OLIMEX/iMX8MP-SOM/README.md

# iMX8MP-SOM
i.MX8MPlus System on Module with iMX8 SOC
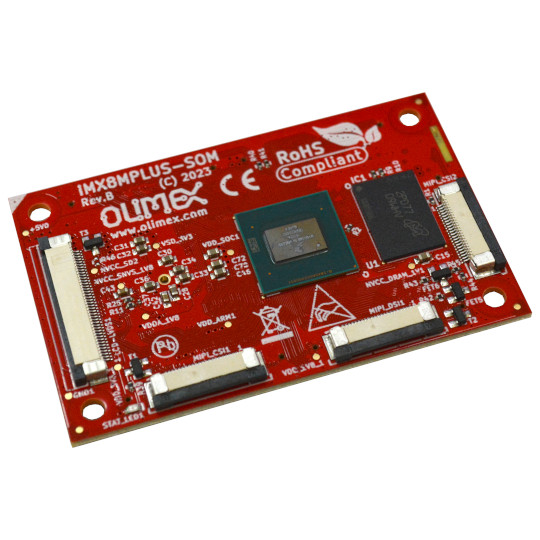
[picture p1: DOCUMENTS/imx8mp-som.jpg]
imx8mp-som


## Licensee
* Hardware is released under CERN Open Hardware Licence Version 2 - Strongly Reciprocal
* Software is released under GPL V3 Licensee
* Documentation is released under CC BY-SA 4.0
