OLIMEX/iMX8MP-SOM/HARDWARE/README.txt

The design was made with KiCAD version 5.1.12.

If you notice problems with PCB or schematic, please use exactly the same version.
