OLIMEX/iMX8MP-SOM/DOCUMENTS/imx8mp-som-a.jpg

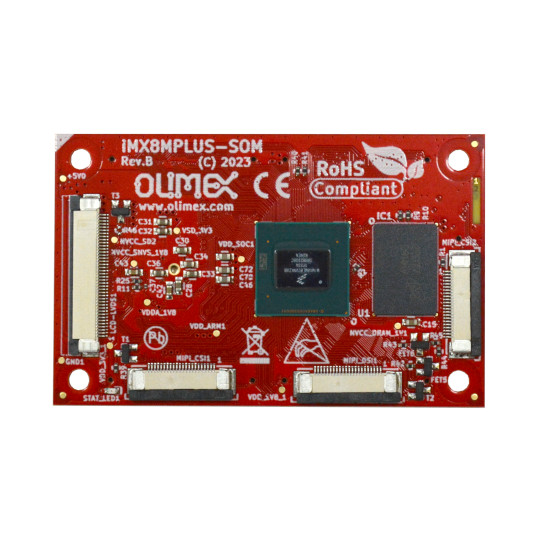
DOCUMENTS/imx8mp-som-a.jpg
