OLIMEX/iMX8MP-SOM/DOCUMENTS/imx8mp-som-b.jpg

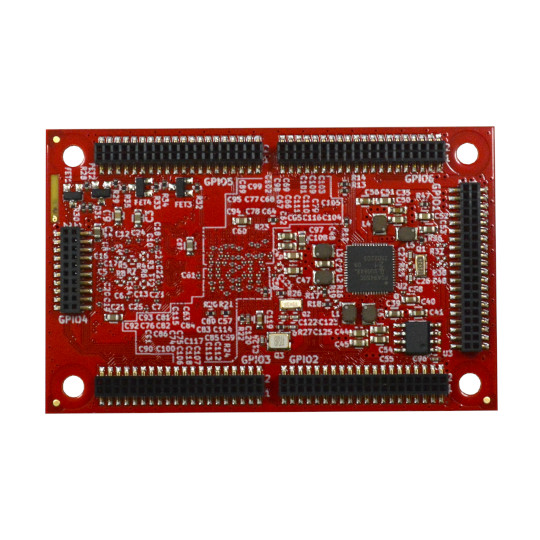
DOCUMENTS/imx8mp-som-b.jpg
