OLIMEX/iMX8MP-SOM/HARDWARE/iMX8MP-SOM-xGB-IND/3d/FPV-WZB21-22-LF_Molex-524372233.stp

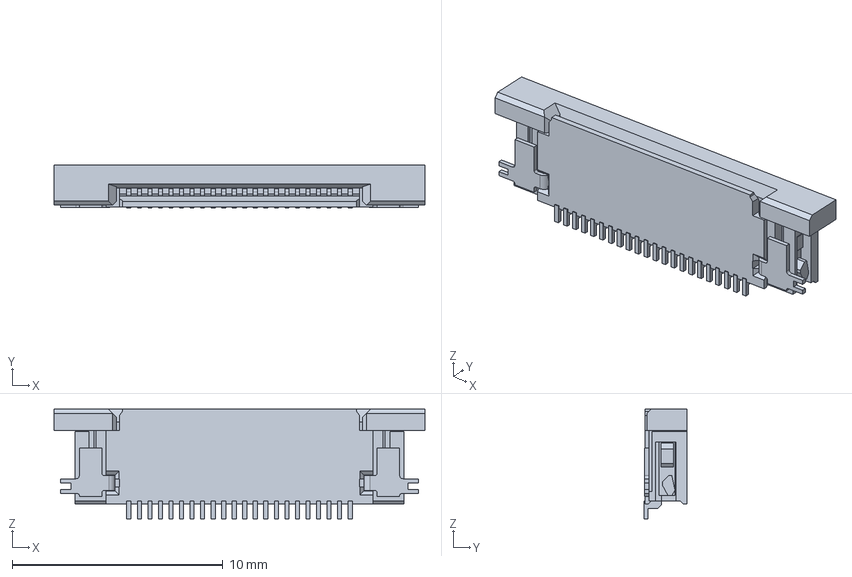
[picture p4: CAD file, 2024-09-25]
HARDWARE/iMX8MP-SOM-xGB-IND/3d/FPV-WZB21-22-LF_Molex-524372233.stp
17.6 x 2.04 x 5.20 mm
