OLIMEX/iMX8MP-SOM/HARDWARE/iMX8MP-SOM-xGB-IND/3d/QSG5032.step

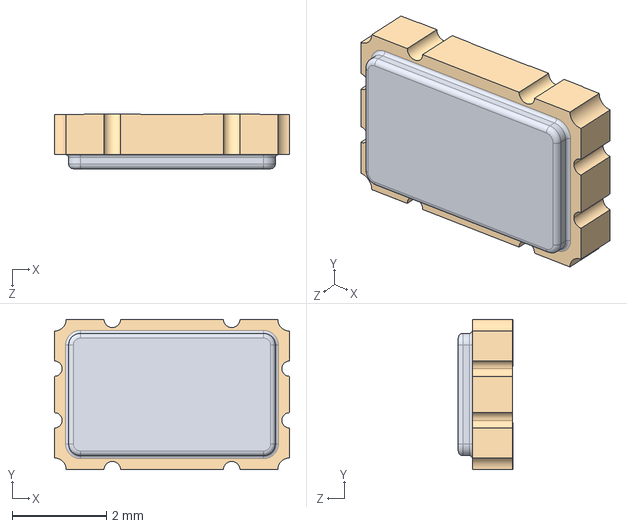
[picture p5: CAD file, 2024-09-25]
HARDWARE/iMX8MP-SOM-xGB-IND/3d/QSG5032.step
5.00 x 3.20 x 1.16 mm
