OLIMEX/iMX8MP-SOM/HARDWARE/iMX8MP-SOM-xGB-IND/3d/L-INDM2520X190N.STEP

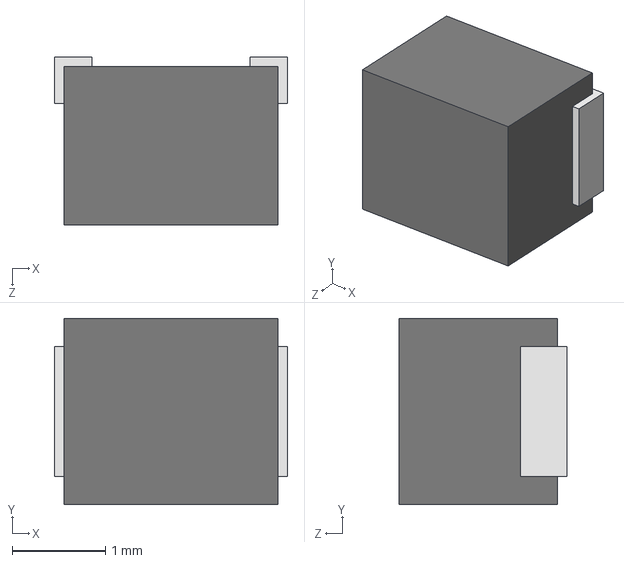
[picture p6: CAD file, 2024-09-25]
HARDWARE/iMX8MP-SOM-xGB-IND/3d/L-INDM2520X190N.STEP
2.50 x 2.00 x 1.80 mm
