OLIMEX/iMX8MP-SOM/HARDWARE/iMX8MP-SOM-xGB-IND/3d/SO-8_150mil---SN65HVDA1050AQDRQ1.STEP

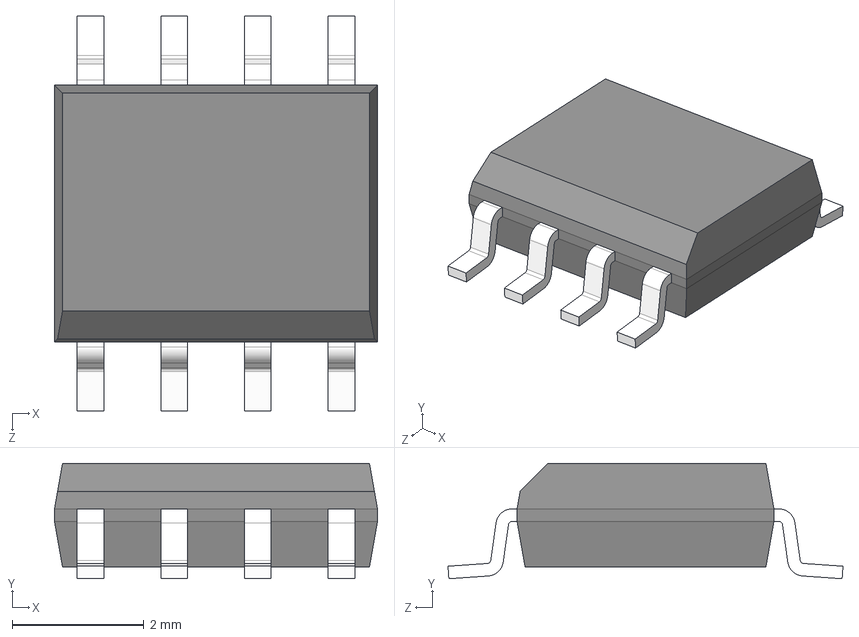
[picture p7: CAD file, 2024-09-25]
HARDWARE/iMX8MP-SOM-xGB-IND/3d/SO-8_150mil---SN65HVDA1050AQDRQ1.STEP
4.90 x 1.75 x 5.99 mm
