OLIMEX/iMX8MP-SOM/HARDWARE/iMX8MP-SOM-xGB-IND/3d/SOT-23.step

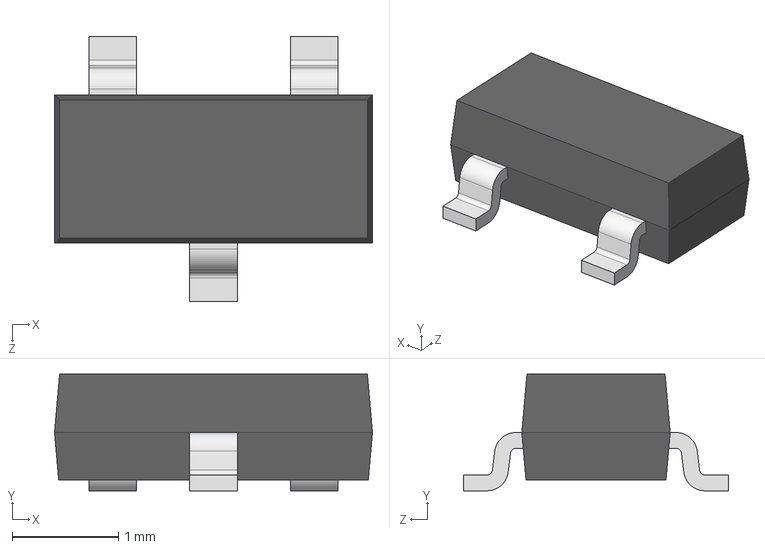
[picture p8: CAD file, 2024-09-25]
HARDWARE/iMX8MP-SOM-xGB-IND/3d/SOT-23.step
3.00 x 1.10 x 2.50 mm
