OLIMEX/iMX8MP-SOM/HARDWARE/iMX8MP-SOM-xGB-IND/3d/User Library-HQFN 56.STEP

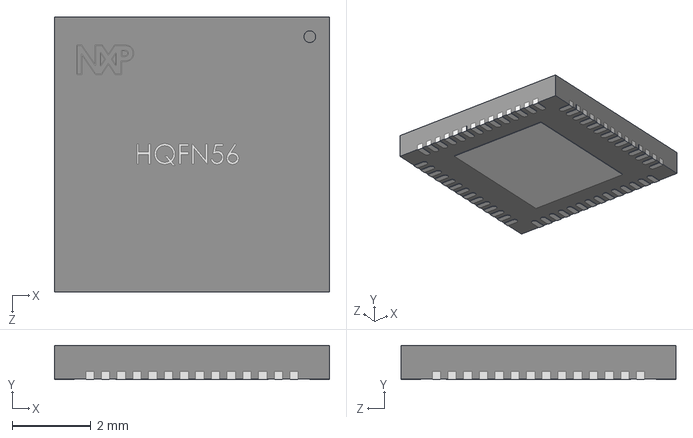
[picture p9: CAD file, 2024-09-25]
HARDWARE/iMX8MP-SOM-xGB-IND/3d/User Library-HQFN 56.STEP
7.00 x 0.87 x 7.00 mm
