OLIMEX/iMX8MP-SOM/HARDWARE/iMX8MP-SOM-xGB-IND/3d/BGA-200(IS46LQ32128A-062BLA).STEP

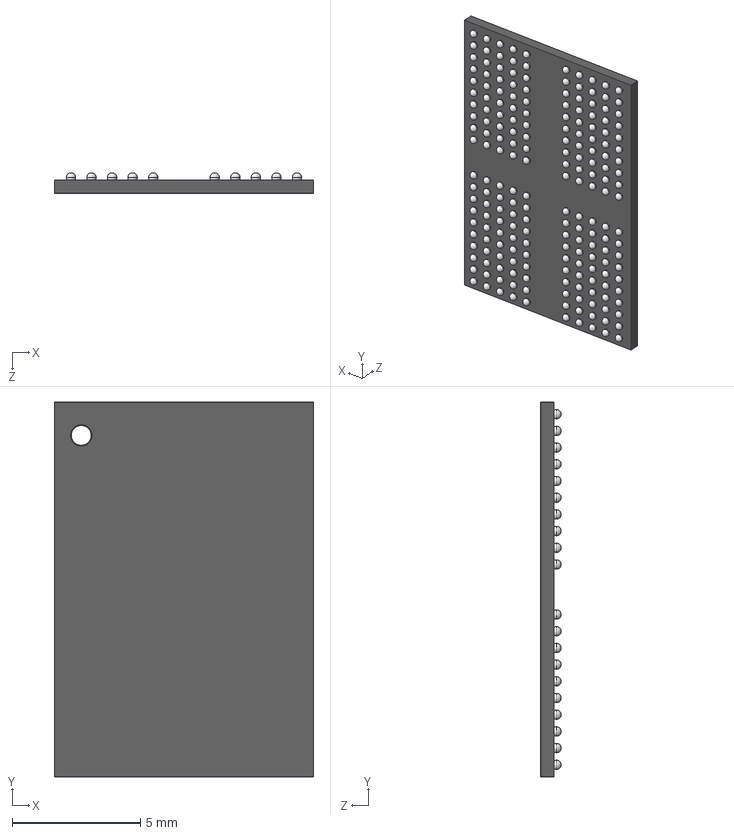
[picture p10: CAD file, 2024-09-25]
HARDWARE/iMX8MP-SOM-xGB-IND/3d/BGA-200(IS46LQ32128A-062BLA).STEP
10.1 x 14.6 x 0.8 mm
