OLIMEX/iMX8MP-SOM/HARDWARE/iMX8MP-SOM-xGB-IND/3d/Q32.768kHz_12.5pF_2P_SMD1206---ECS-.327-12.5-34B-C-TR.STEP

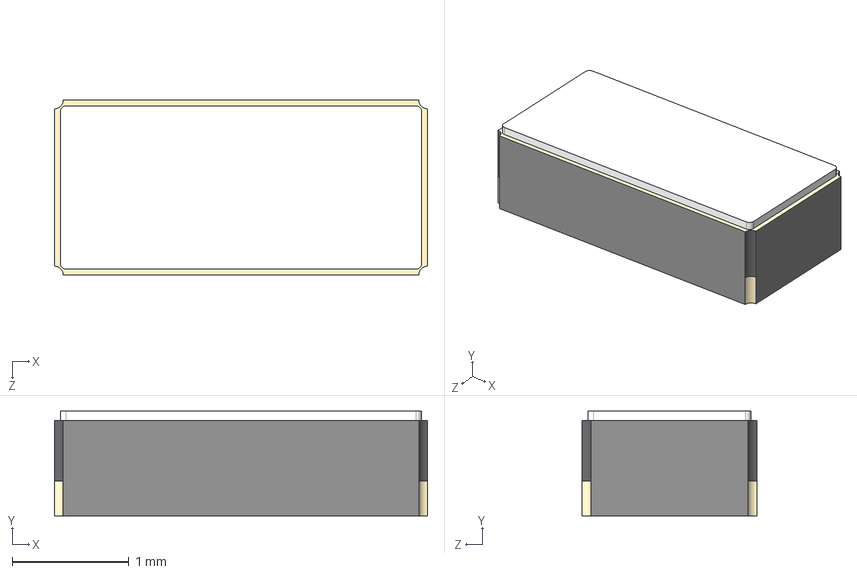
[picture p11: CAD file, 2024-09-25]
HARDWARE/iMX8MP-SOM-xGB-IND/3d/Q32.768kHz_12.5pF_2P_SMD1206---ECS-.327-12.5-34B-C-TR.STEP
3.20 x 0.9 x 1.50 mm
