OLIMEX/iMX8MP-SOM/HARDWARE/iMX8MP-SOM-xGB-IND/3d/FPV-WZA21-40-LF_Molex-541044033.stp

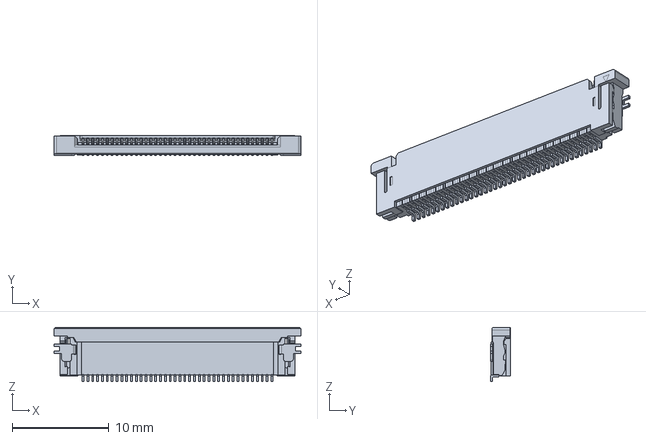
[picture p12: CAD file, 2024-09-25]
HARDWARE/iMX8MP-SOM-xGB-IND/3d/FPV-WZA21-40-LF_Molex-541044033.stp
25.5 x 2.05 x 5.60 mm
