OLIMEX/iMX8MP-SOM/HARDWARE/iMX8MP-SOM-xGB-IND/3d/YA-V36P-2X20-LF-Amphenol_ICC(FCI)_20021321-00040T4LF.stp

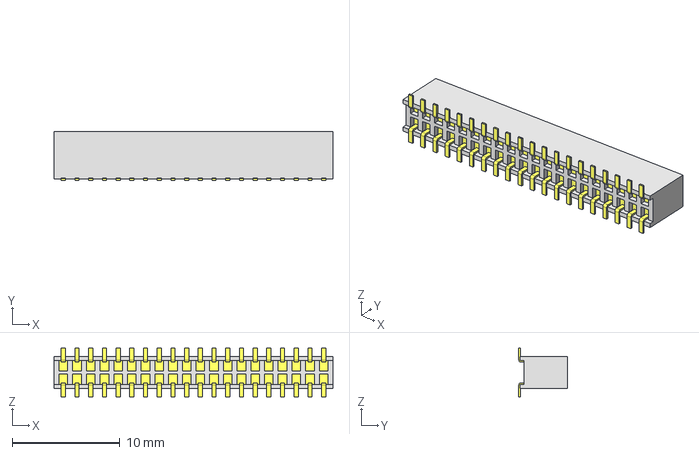
[picture p14: CAD file, 2024-09-25]
HARDWARE/iMX8MP-SOM-xGB-IND/3d/YA-V36P-2X20-LF-Amphenol_ICC(FCI)_20021321-00040T4LF.stp
25.9 x 4.50 x 4.50 mm
_20021321-00040T4LF_body
_20021321-00040T4LF_pins
