OLIMEX/iMX8MP-SOM/DOCUMENTS/iMX8MP-SOM-4GB-IND-user-manual.odt

IMX8MP-SOM-xGB-IND

User Manual

document revision 3.0 www.olimex.com

# iMX8MP-SOM-4GB-IND board features

iMX8MP-SOM-4GB-IND (https://www.olimex.com/Products/SOM/NXP-iMX8/iMX8MP-SOM-4GB-IND/open-source-hardware) exposes all MIMX8ML8CVNKZAB GPIOs and features in a very compact format. It takes care for power supply and high speed memory signals complexities.

- Main chip: i.MX 8M Plus – MIMX8ML8CVNKZAB – Quad core Cortex-A53@1600Mhz + Arm Cortex-M7@800 Mhz
- 4GB LPDDR4 RAM
- PMIC PCA9450
- 24 Mhz crystal
- 32.768 kHz crystal
- EEPROM memory (for Linux configuration or settings)
- Power LED
- User LED
- 5 x 40 pin + 1 x 20 pin total 220 pin connectors with 1.27 mm/0.05" step
- LVDS, 2 x MIPI CSI, MIPI DSI ribbon connectors on top
- Extended operating temperature – from -20°C to +85°C
- Dimensions: (70 x 43)mm
- 4 holes for mounting
- Open source hardware design, all KiCAD design files available for download

Compatible with iMX8MP-SOM-EVB-IND (https://www.olimex.com/Products/SOM/NXP-iMX8/iMX8MP-SOM-EVB-IND/open-source-hardware) – iMX8MP-SOM-4GB-IND can be placed on top of expansion board for easier R&D and prototyping.

# MIMX8ML8CVNKZAB chip features

The main chip has the following features:

- MIMX8ML8CVNKZAB Quad core Cortex-A53 @1600Mhz + Arm Cortex-M7 @800 Mhz
- 512KB Cache
- Vivante GC520L, Vivante GC7000UL
- HDMI HD1080p60 H.264, HD1080p60 H.265, VP8 video codec, VP9 video codec
- MIPI-DSI
- LVDS 4/8 lanes
- NPU 2.3 TOPS
- 2 x Gigabit Ethernet (1 x TSN)
- 2 x MIPI-CSI camera
- 1 x ISP camera
- 2 x USB3 with OTG
- 1 x PCIe 3.0
- 2 x CAN FD
- 3 x SPI
- 5 x I2C
- 3 x SDIO eMMC 5.1
- 4 x UART 5Mbit
- 4 x PWM
- Audio: ASRC, HiFi 4 DSP, SAI/I2S, eARC

# iMX8MP-SOM-EVB-IND board of peripherals features

(https://www.olimex.com/Products/SOM/NXP-iMX8/iMX8MP-SOM-EVB-IND/open-source-hardware)

iMX8MP-SOM-EVB-IND (https://www.olimex.com/Products/SOM/NXP-iMX8/iMX8MP-SOM-EVB-IND/open-source-hardware) can be placed on top of expansion board for easier R&D and prototyping. It has the following features:

- iMX8MP-SOM matching connectors
- Two Gigabit Ethernet connectors
- Two CAN transceivers
- HDMI output connector
- Power jack for 5V DC
- Two serial debug UARTs (for A53 and M7)
- Micro SD-card connector
- Flash module connector
- Two USB 3.0 hosts
- PCI Express 3.0 M.2 expansion slot (2280) for nVME
- Headphone 3.5mm connector
- Microphone 3.5 mm connector
- Reset button
- PWR button
- UEXT connector
- Two GPIO connectors at 0.1" step
- Optional ARM JTAG connector
- Boot slide switch
- Open-hardware design, design made with KiCAD
- Industrial grade temperature range: (-45+85)C
- Dimensions: (155 x 102)mm

## Order codes for iMX8MP-SOM and accessories

iMX8MP-SOM-EVB (https://www.olimex.com/Products/SOM/NXP-iMX8/iMX8MP-SOM-EVB-IND/) Expansion board for easy evaluation of iMX8MP-SOM which can be used as reference design; requires SOM module iMX8MP- SOM-4GB-IND

iMX8MP-SOM-4GB-IND (https://www.olimex.com/Products/SOM/NXP-iMX8/iMX8MP-SOM-4GB-IND/open-source-hardware) Main module with i.MX8 quad-core MIMX8ML8CVNKZAB, 4GB LPDDR4, EEPROM, PMIC

If you have the EVB board you can attach extra peripherals:

MICRO-SD-16GB-CLASS10 (https://www.olimex.com/Products/Components/Storage/MICRO-SD-16GB-CLASS10/) Blank 16GB microSD card

USB-CARD-READER (https://www.olimex.com/Products/USB-Modules/USB-CARD-READER/) USB card reader and writer

SY1505E (https://www.olimex.com/Products/Power/SY1505E/) Power adapter 5V 3A

SY2005E (https://www.olimex.com/Products/Power/SY2005E/) Power adapter 5V 5A

USB-SERIAL-F (https://www.olimex.com/Products/Components/Cables/USB-Serial-Cable/USB-SERIAL-F/) Serial debug cable for console log

Flash-e32Gs16M (https://www.olimex.com/Products/OLinuXino/Accessories/Flash-e32Gs16M/) Plug-and-play eMMC and SPI memory expansion module

CABLE-HDMI-50CM (https://www.olimex.com/Products/Components/Cables/CABLE-HDMI-50CM/) HDMI cable

USB-KEYBOARD-PS2 (https://www.olimex.com/Products/USB-Modules/USB-KEYBOARD-PS2/) Mini keyboard

PWR-CABLE (https://www.olimex.com/Products/Components/Cables/PWR-CABLE/) Cable with free leads fitting the Olimex barrel jacks

UEXT modules (https://www.olimex.com/Products/Modules/) There are temperature, humidity, pressure, magnetic field, light sensors. Modules with LCDs, LED matrix, Relays, Bluetooth, Zigbee, WiFi, GSM, GPS, RFID, RTC, EKG, sensors and etc.

# HARDWARE

## iMX8MP-SOM layout


MIMX8ML8CVNKZAB

32Gb LPDDR4

Orientation mark

MIPI-CSI2

LCD LVDS

MIPI-CSI1

MIPI-DSI


EEPROM

GPIO2

GPIO3

PMIC

GPIO1

GPIO6

GPIO5

GPIO4

GPIO3

GPIO2

## iMX8MP-SOM schematics

iMX8MP-SOM-4GB-IND (https://github.com/OLIMEX/iMX8MP-SOM/blob/main/HARDWARE/iMX8MP-SOM-xGB-IND/iMX8MPLUS-SOM_Rev_B.pdf) latest schematic is at our GitHub.

Hardware sources and more can also be found here:

https://github.com/OLIMEX/iMX8MP-SOM/tree/main/HARDWARE

## iMX8MP-SOM connectors

### GPIO1

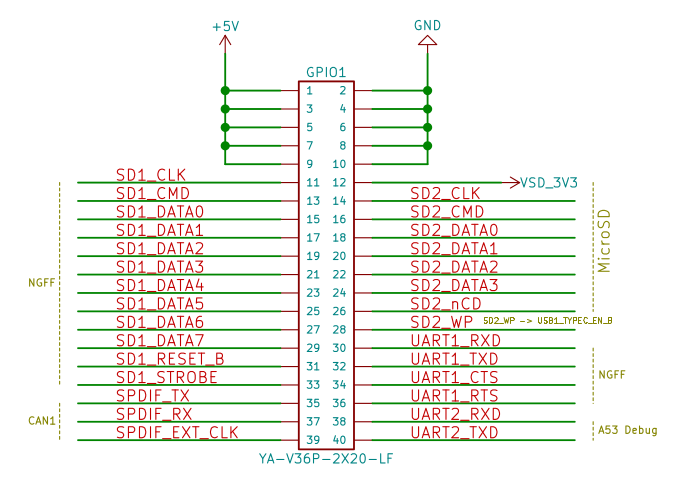
[picture p15: figure]

### GPIO2

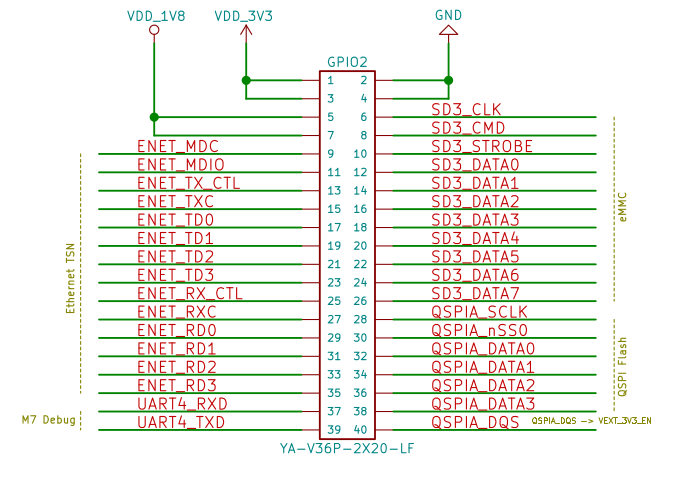
[picture p16: figure]

### GPIO3

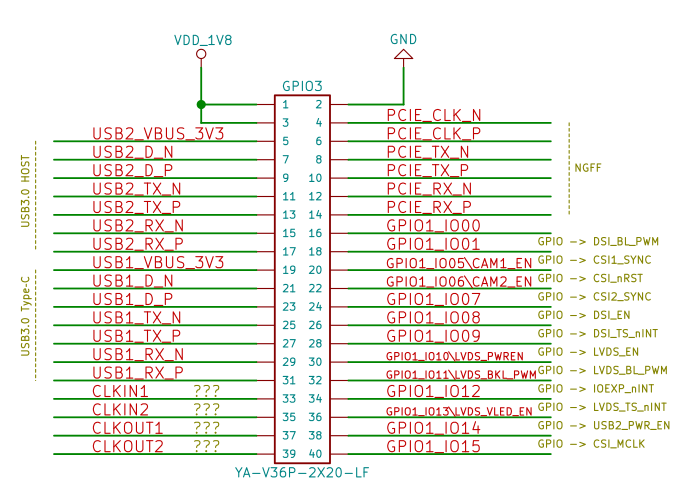
[picture p17: figure]

### GPIO4

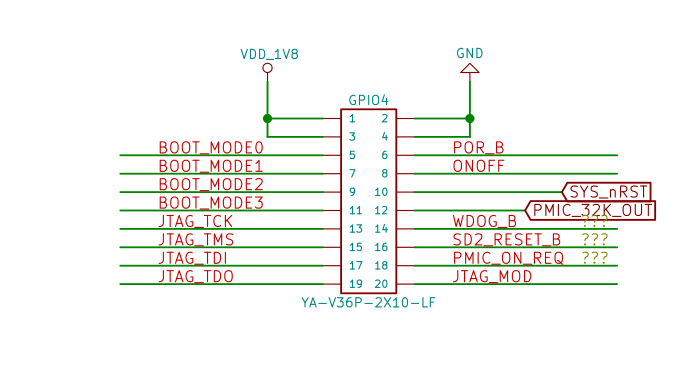
[picture p18: figure]

### GPIO5

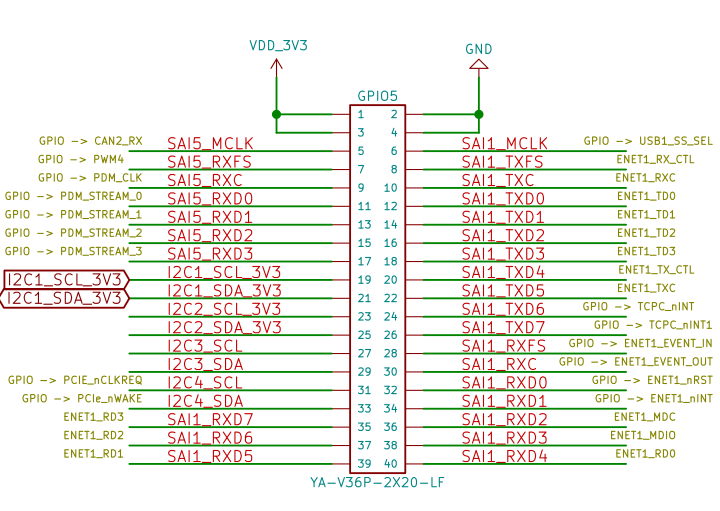
[picture p19: figure]

### GPIO6

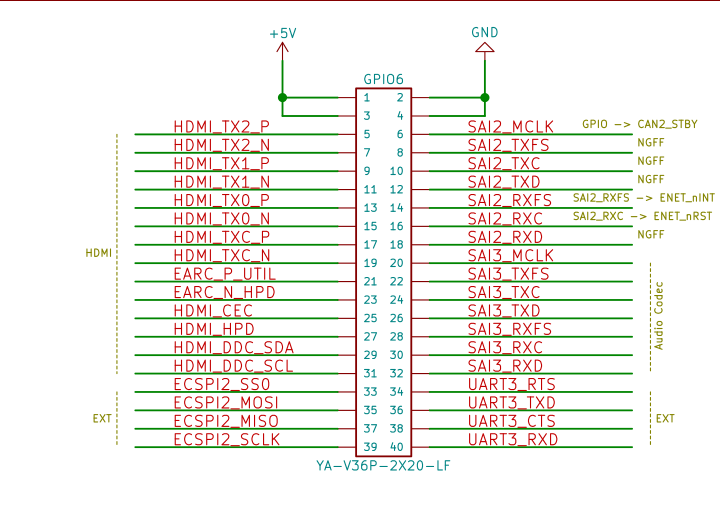
[picture p20: figure]

### LCD

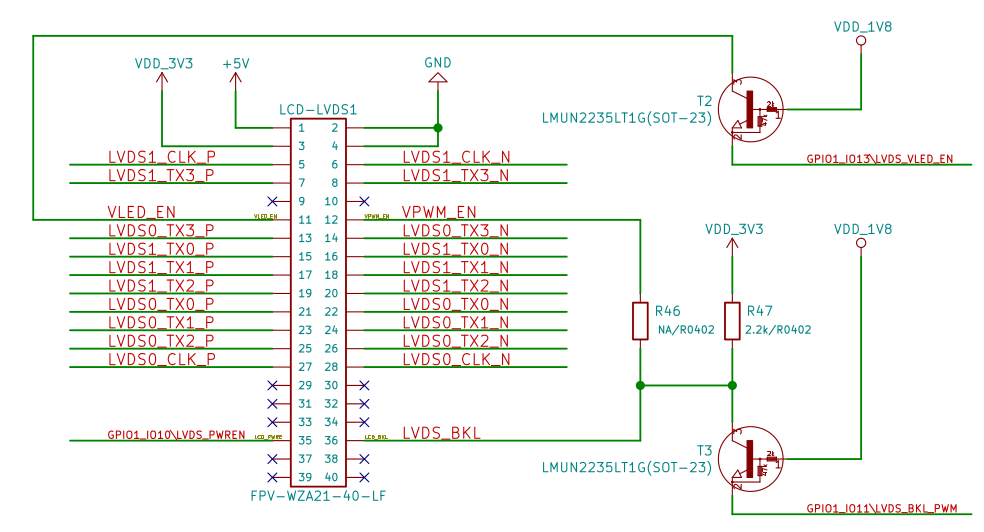
[picture p21: figure]

### MIPI-DSI

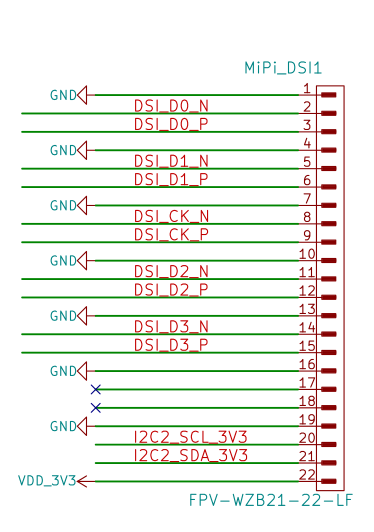
[picture p22: figure]

### MIPI-CSI

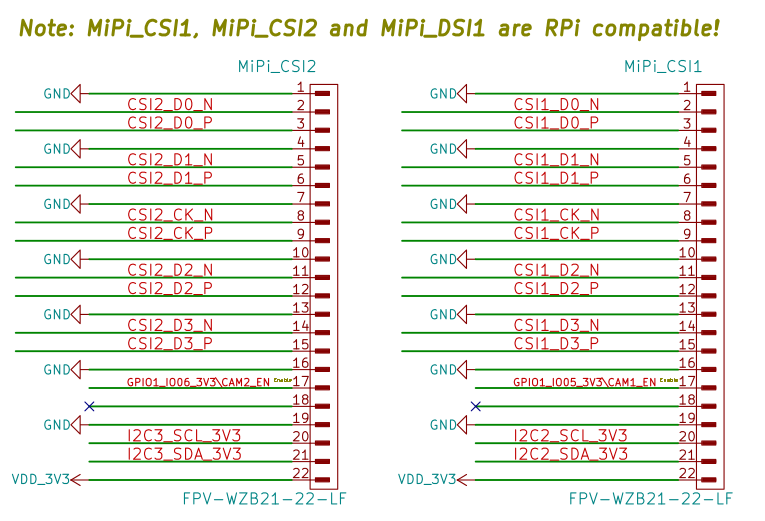
[picture p23: figure]

### EEPROM

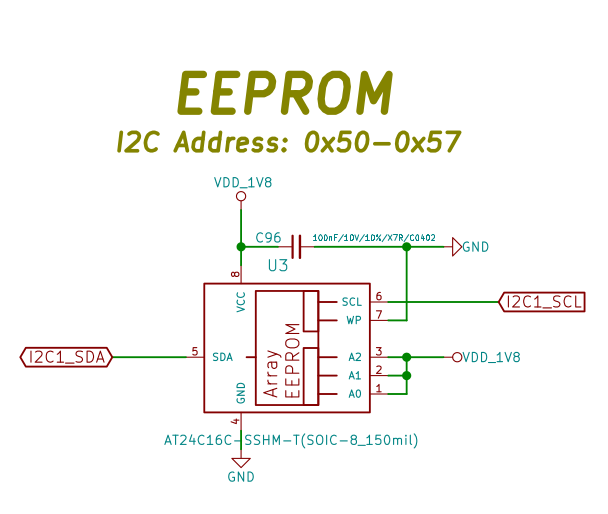
[picture p24: figure]

### User LED

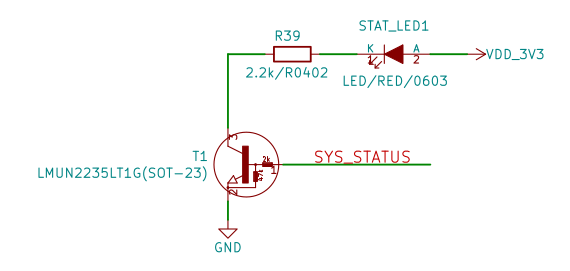
[picture p25: figure]

# SOFTWARE

You can find Olimex-maintained recommended images here:

# Recommended Olimage Linux images (https://images.olimex.com/release/imx8mp/)

It is recommended to start with the base Armbian image. The minimal Armbian image has no graphical user interface.

The software we provide and maintain for iMX8MP-SOM-EVB is the same as for the main board:

- Armbian-based Debian 12 “bookworm” images (base and minimal) with support for the main chip and most peripherals, like USB 3.0, GbE, NVMe M.2 slot, Flash-header slot, serial debug, HDMI output (+audio over HDMI), CAN, etc. Known software issues: Currently there is no support for the ES8388 audio driver, e.g. HEADPHONES1 and MICROPHONE1 jacks won’t work without additional software work (HDMI audio works ok).

- Buildroot setup

# Document Revision History

Revision 3.0 Feburary 2025

- Removed misleading links

- Added info about new Armbian-based Debian release

Revision 2.0 December 2024

- Improved formatting

- Fixed wrong info about Linux available

Revision 1.0 May 2024

- Initial document
