OLIMEX/iMX8MP-SOM/(threads)

Thread 1 (2024-06-02):

Missing Drawing sheets

Kreyren, 2024-06-02:
```
02:00:49 PM: Drawing sheet '/home/penko/SVN_Checkout/important_DOCs/KiCad-New_Page_Layouts/A4-Landscape-1.kicad_wks' not found.
02:00:49 PM: Drawing sheet '/home/penko/SVN_Checkout/important_DOCs/KiCad-New_Page_Layouts/A4-Landscape-1.kicad_wks' not found.
```

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

Thread 2 (2024-06-02):

2023?

Kreyren, 2024-06-02:
The project seems to have appeared on the olimex website around 18/05/2024, but the schematics say 2023:

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

Was this designed a year ago to the data or is that a wrong date?

Thread 3 (2024-06-02):

Add fabricating instructions

Kreyren, 2024-06-02:
These are missing and it's not a good practice to guestimate them (was a real pain to figure these out for teres pcbs for me):

* Material Type: (minimal, optimal and maximal TG for the FR4 board)
* Material Thickness (0.2~3.2mm)

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
* Min track/spacing: 3/3mm ~ 8/8mil
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

* Min hole size: (0.15 ~ 1.0mm)
* Min Via hole size/diameter
* Surface Finish (ENIG?)
* Outer Copper Weight/Finished copper
* Inner Copper Weight
* Board Outline Tolerance
* Via Covering (Tented, Epoxy Filled & Untented, Plugged, Epoxy Filled & Capped, Copper paste Filled & Capped)

\* Options taken from own (no buried or closed vias) + local + EU + foreign
\* For details to these options refer to jlcpcb or pcbway's instant quote forms.
