OLIMEX/iMX8MP-SOM/HARDWARE/iMX8MP-SOM-xGB-IND/iMX8MPLUS-SOM_Rev_B.pdf

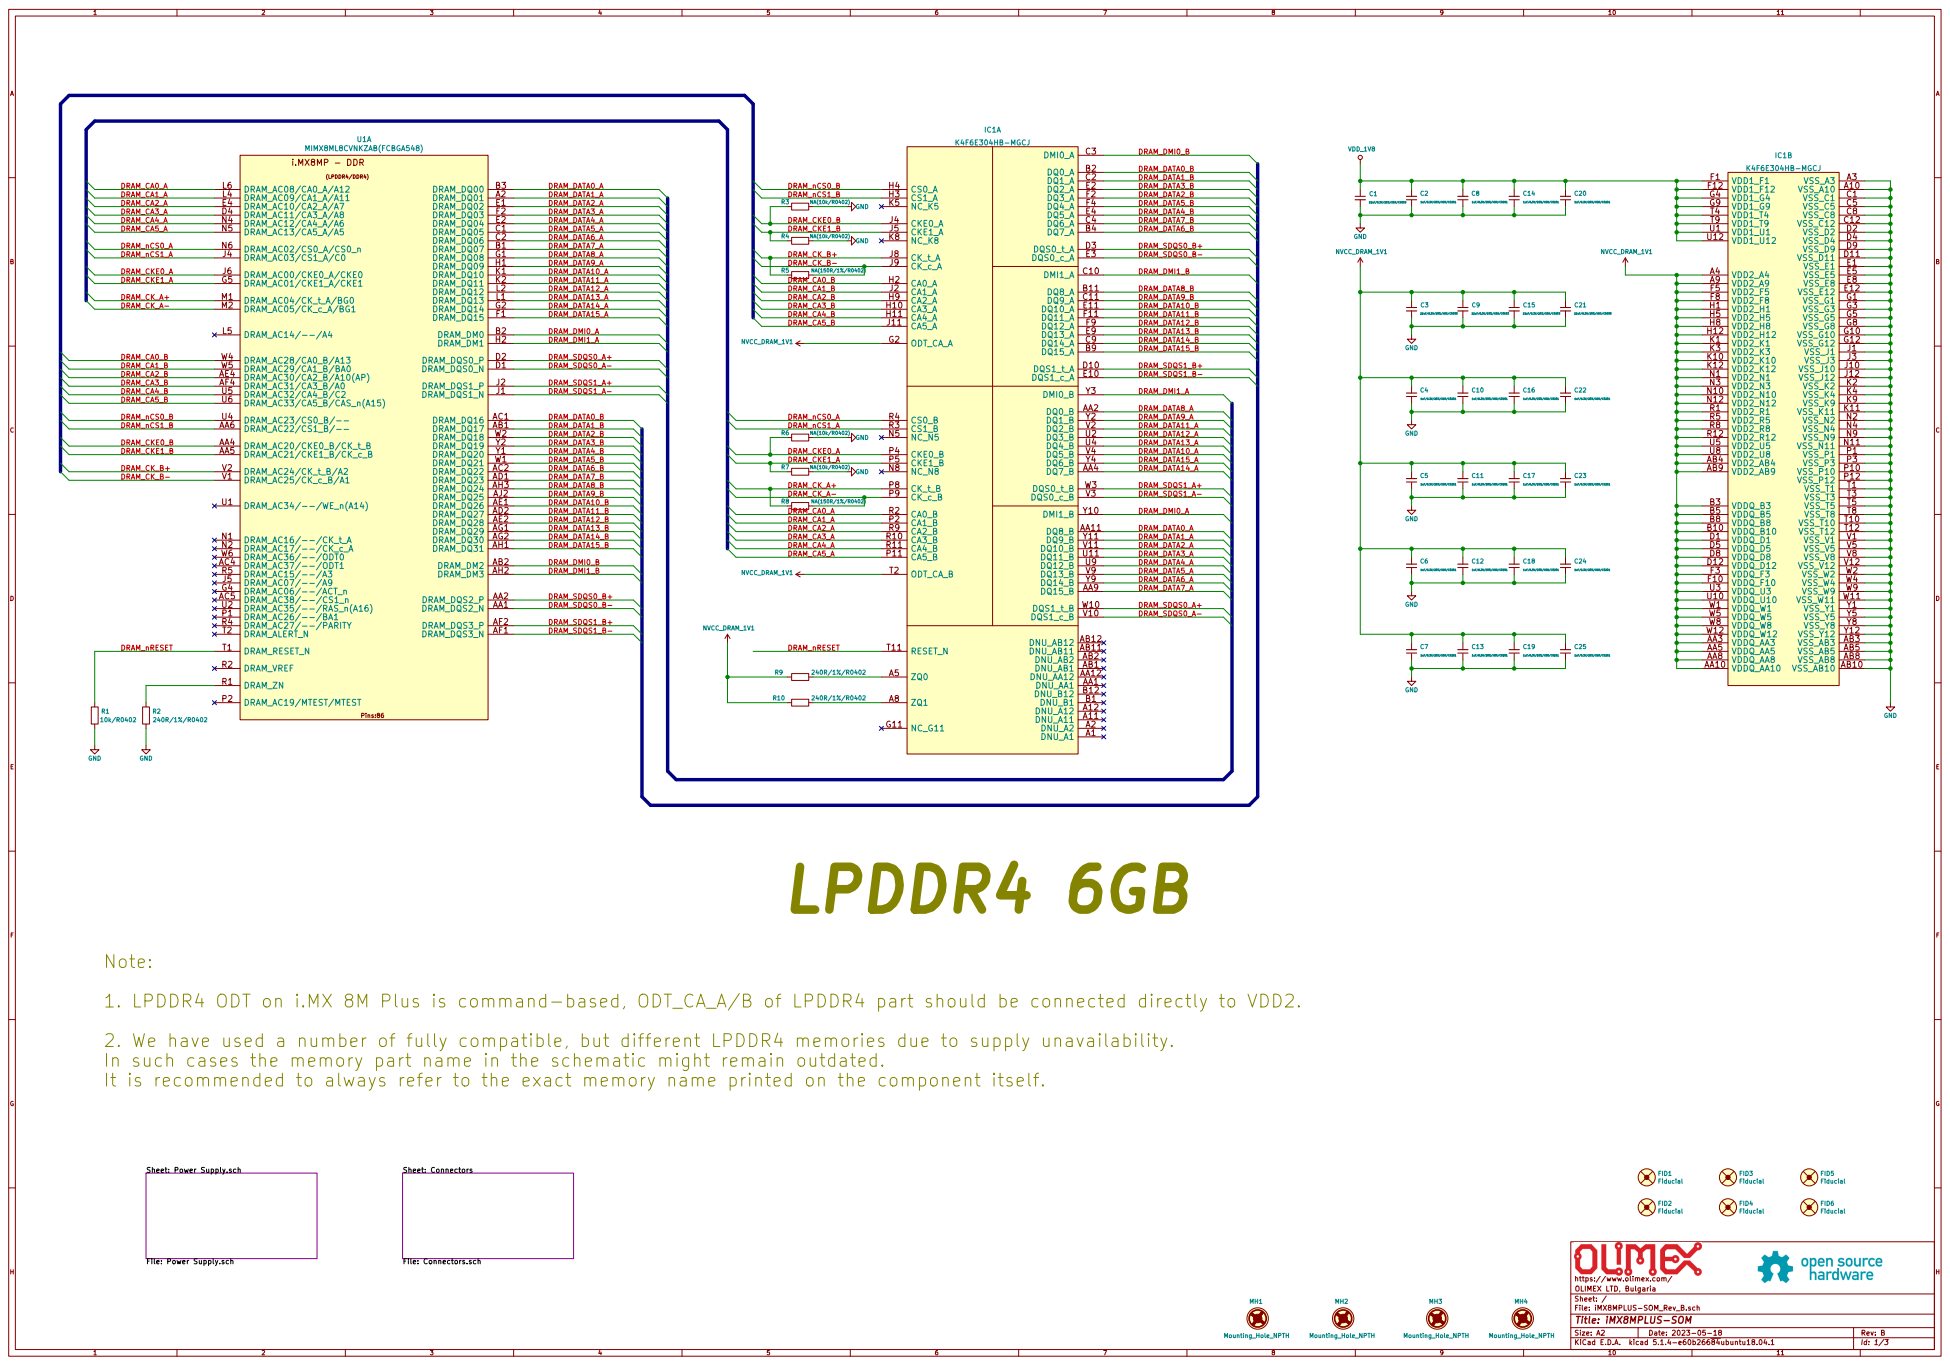
[picture p26: page 1]

Note:
1. LPDDR4 ODT on i.MX 8M Plus is command-based, ODT_CA_A/B of LPDDR4 part should be connected directly to VDD2.
2. We have used a number of fully compatible, but different LPDDR4 memories due to supply unavailability.
In such cases the memory part name in the schematic might remain outdated.
It is recommended to always refer to the exact memory name printed on the component itself.

File: iMX8MPLUS-SOM_Rev_B.sch Sheet: / OLIMEX LTD, Bulgaria

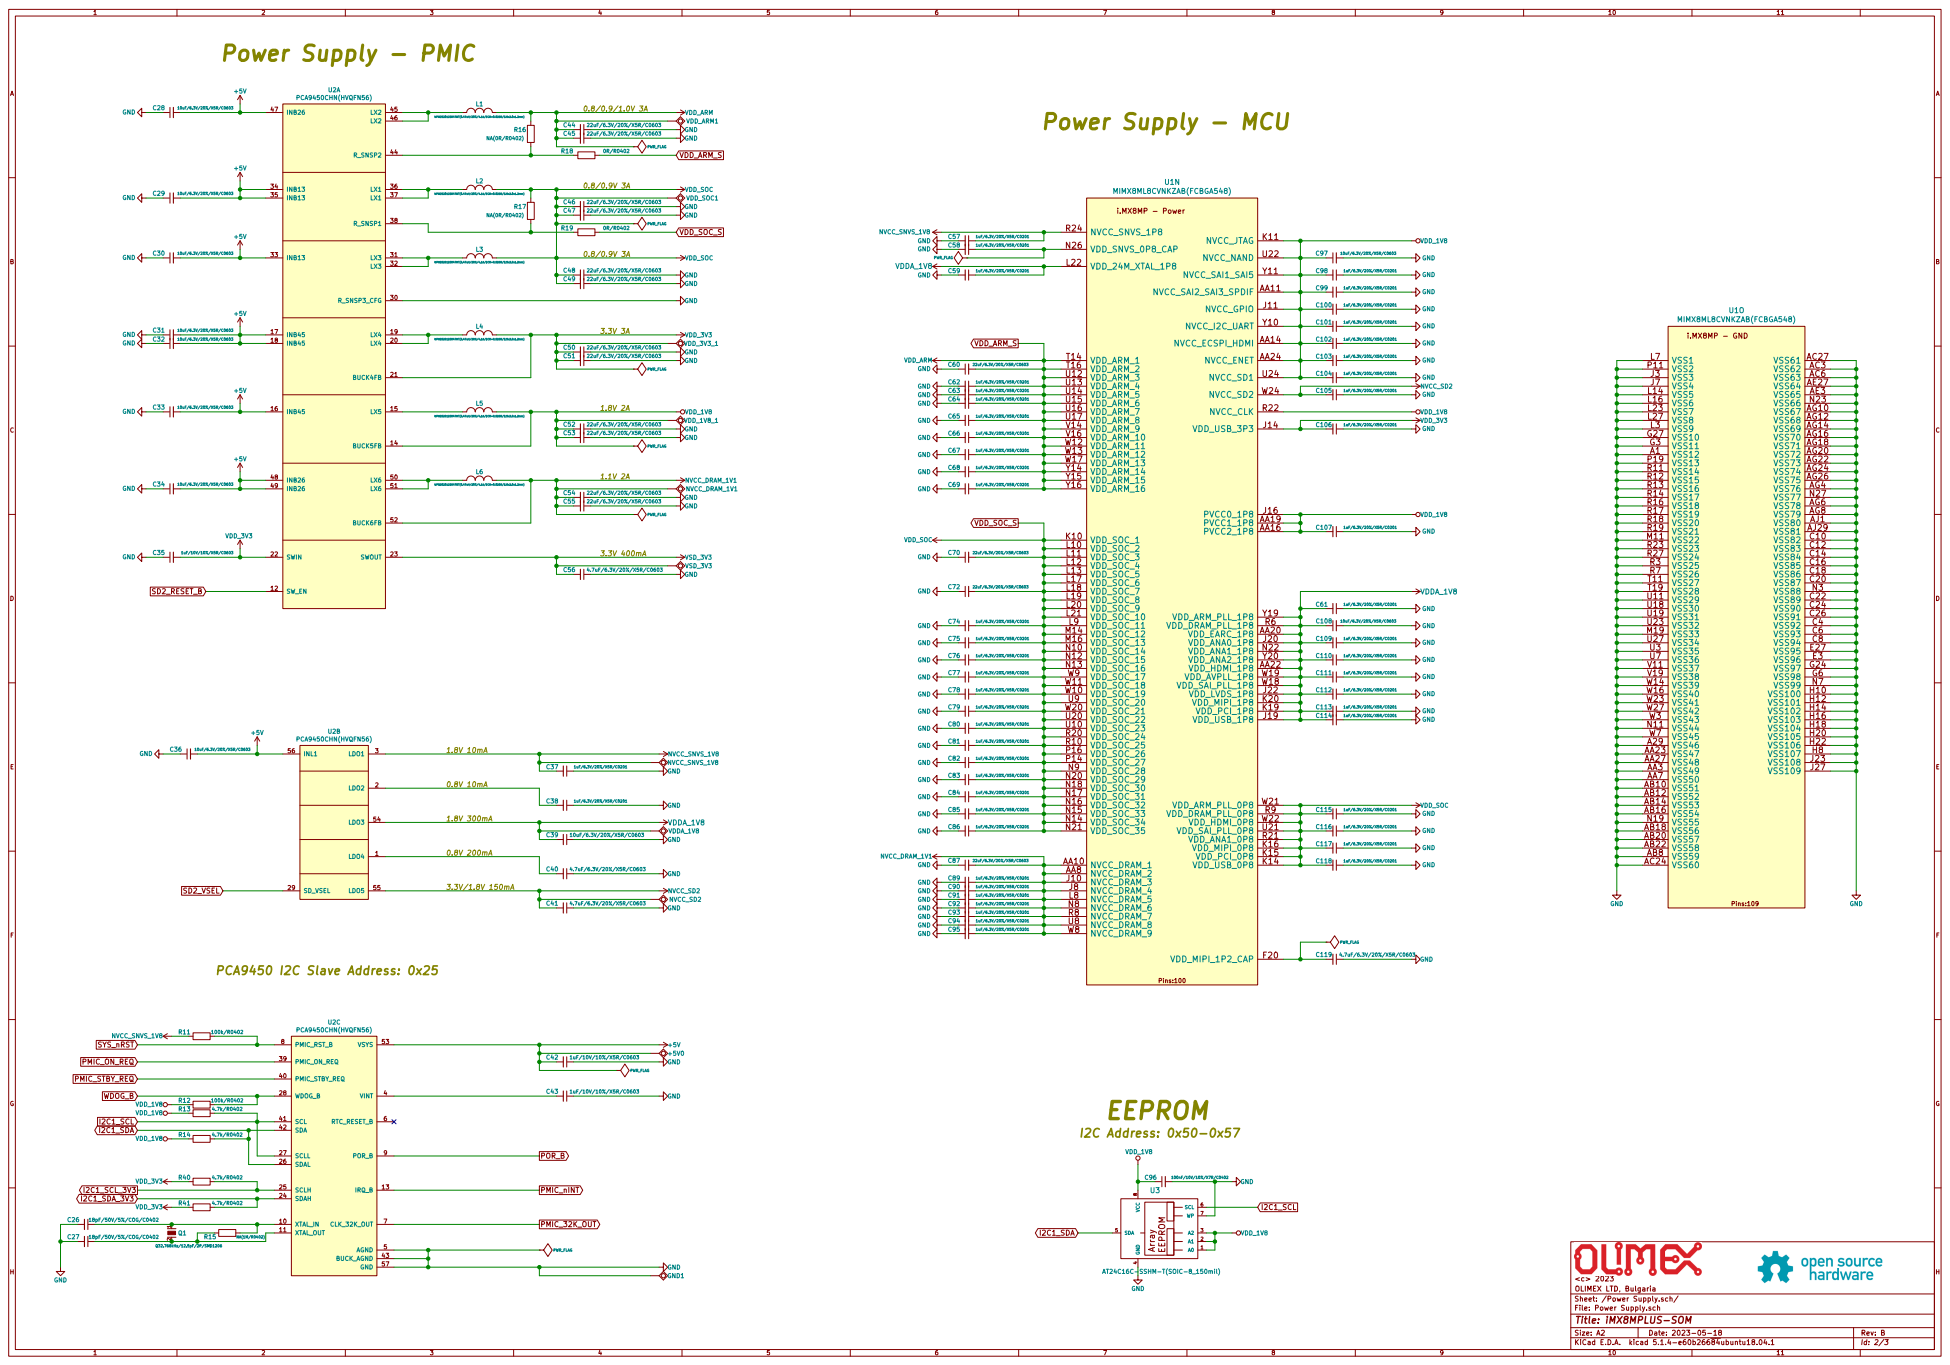
[picture p27: page 2]

GND GND GND GND

GND
VDD_SOC GND GND GND GND GND GND GND

File: Power Supply.sch Sheet: /Power Supply.sch/ OLIMEX LTD, Bulgaria <c> 2023

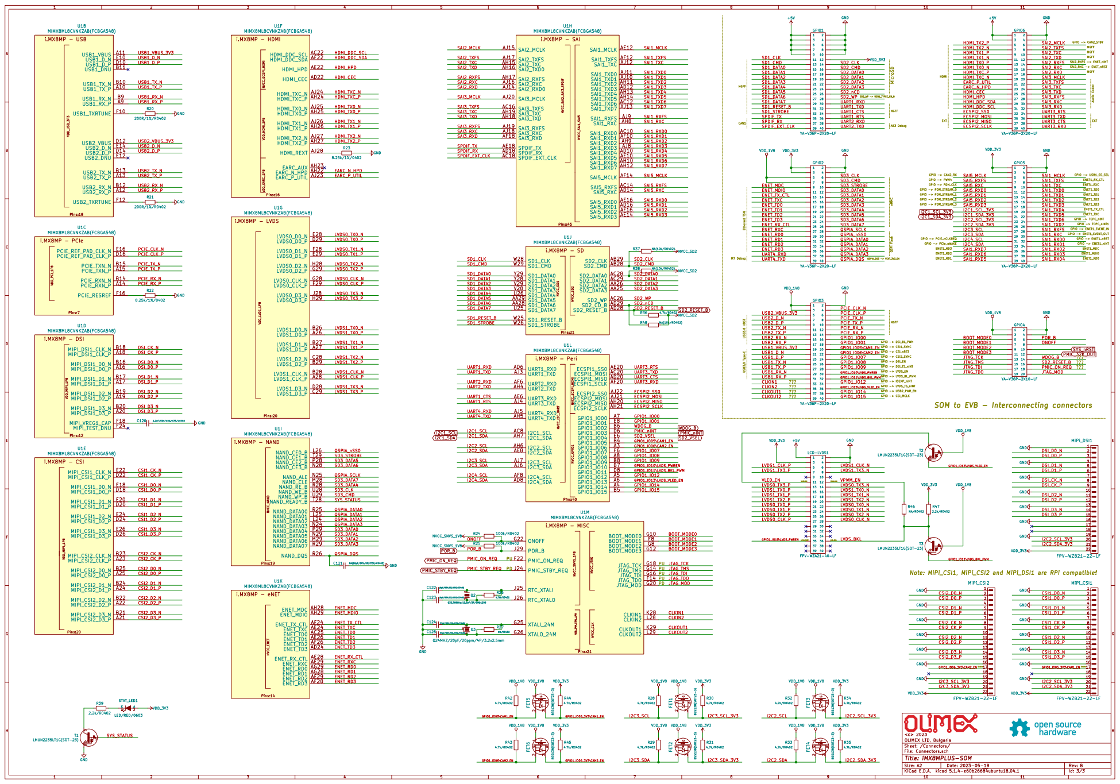
[picture p28: page 3]

ENET1_TX_CTL ENET1_TXC Note: MiPi_CSI1, MiPi_CSI2 and MiPi_DSI1 are RPi compatible!
I2C1_SCL_3V3

ENET1_RD3 GPIO -> CSI2_SYNC GPIO -> DSI_EN GPIO -> DSI_TS_nINT GPIO -> LVDS_EN GPIO -> LVDS_BL_PWM

GPIO -> IOEXP_nINT GPIO -> LVDS_TS_nINT GPIO -> USB2_PWR_EN GPIO -> CSI_MCLK

CSI1_D0_P CSI1_D0_N
GND GND

File: Connectors.sch Sheet: /Connectors/ OLIMEX LTD, Bulgaria <c> 2023 R31
