OLIMEX/iMX8MP-SOM/HARDWARE/iMX8MP-SOM-xGB-IND/Connectors.sch

## KiCad design HARDWARE/iMX8MP-SOM-xGB-IND/Connectors.sch (2024-09-25)

Schematic: Connectors.sch

Parts:
C120: 2.2nF/50V/10%/X7R/C0402; C_0402_5MIL_DWS
C121: NA(18pF/50V/5%/COG/C0402); C_0402_5MIL_DWS
C122, C123: 18pF/50V/5%/COG/C0402; C_0402_5MIL_DWS
C124, C125: 33pF/50V/5%/COG/C0402; C_0402_5MIL_DWS
FET1, FET2, FET3, FET4, FET5, FET6: BSS138(SOT23-3); SOT23
GPIO1, GPIO2, GPIO3, GPIO5, GPIO6: YA-V36P-2X20-LF; GPCB127SMT-02X20(YA-V36P-2X20-LF)
GPIO4: YA-V36P-2X10-LF; GPCB127SMT-02X10(YA-V36P-2X10-LF)
LCD-LVDS1: FPV-WZA21-40-LF
MiPi_CSI1, MiPi_CSI2: FPV-WZB21-22-LF
MiPi_DSI1: FPV-WZB21-22-LF
Q2: Q32.768kHz/12.5pF/2P/SMD1206; CM7V-T1A(Crystal_Package-1206_3.20x1.50x0.65mm)
Q3: Q24MHZ/20pF/20ppm/4P/3.2x2.5mm; TSX-3.2x2.5mm_GND(3)
R20, R21: 200R/1%/R0402; R_0402_5MIL_DWS
R22, R23: 8.25k/1%/0402; R_0402_5MIL_DWS
R24, R25: 100k/R0402; R_0402_5MIL_DWS
R26: 4.7M/R0402; R_0402_5MIL_DWS
R27: 1M/R0402; R_0402_5MIL_DWS
R28, R29, R30, R31, R32, R33, R34, R35, R36, R42, R43, R44, R45: 4.7k/R0402; R_0402_5MIL_DWS
R37, R38, R48: NA(10k/R0402); R_0402_5MIL_DWS
R39, R47: 2.2k/R0402; R_0402_5MIL_DWS
R46: NA/R0402; R_0402_5MIL_DWS
STAT_LED1: LED/RED/0603; LED_0603_KA
T1, T2, T3: LMUN2235LT1G(SOT-23); SOT23
U1: MIMX8ML8CVNKZAB(FCBGA548); FCBGA548_Pitch-0.5mm_Ball-0.25mm_Dimensions-15x15x1.5mm

Notes on the sheet:
SD2_WP -> USB1_TYPEC_EN_B
MicroSD
A53 Debug
NGFF
CAN1
SAI2_RXC -> ENET_nRST
SAI2_RXFS -> ENET_nINT
Ethernet TSN
M7 Debug
eMMC
QSPIA_DQS -> VEXT_3V3_EN
QSPI Flash
USB3.0 HOST
USB3.0 Type‐C
HDMI
EXT
Audio Codec
GPIO -> CAN2_STBY
GPIO -> CAN2_RX
GPIO -> PWM4
GPIO -> PDM_CLK
GPIO -> PDM_STREAM_0
GPIO -> PDM_STREAM_1
GPIO -> PDM_STREAM_2
GPIO -> PDM_STREAM_3
GPIO -> USB1_SS_SEL
ENET1_RX_CTL
ENET1_RXC
ENET1_TD0
ENET1_TD1
ENET1_TD2
ENET1_TD3
ENET1_TX_CTL
ENET1_TXC
GPIO -> TCPC_nINT
GPIO -> TCPC_nINT1
GPIO -> ENET1_EVENT_IN
GPIO -> ENET1_EVENT_OUT
GPIO -> ENET1_nRST
GPIO -> ENET1_nINT
ENET1_MDC
ENET1_MDIO
ENET1_RD0
ENET1_RD1
ENET1_RD2
ENET1_RD3
GPIO -> PCIe_nWAKE
GPIO -> PCIE_nCLKREQ
GPIO -> DSI_BL_PWM
GPIO -> CSI1_SYNC
GPIO -> CSI_nRST
GPIO -> CSI2_SYNC
GPIO -> DSI_EN
GPIO -> DSI_TS_nINT
GPIO -> LVDS_EN
GPIO -> LVDS_BL_PWM
GPIO -> IOEXP_nINT
GPIO -> LVDS_TS_nINT
GPIO -> USB2_PWR_EN
GPIO -> CSI_MCLK
???
Enable
LCD_PWRE
LCD_BKL
VPWM_EN
VLED_EN
SOM to EVB - Interconnecting connectors
Note: MiPi_CSI1, MiPi_CSI2 and MiPi_DSI1 are RPi compatible!
