OLIMEX/iMX8MP-SOM/HARDWARE/iMX8MP-SOM-xGB-IND/Power Supply.sch

## KiCad design HARDWARE/iMX8MP-SOM-xGB-IND/Power Supply.sch (2024-09-25)

Schematic: Power Supply.sch

Parts:
+5V0: TESTPAD; TP_SMD
C26, C27: 18pF/50V/5%/COG/C0402; C_0402_5MIL_DWS
C28, C29, C30, C31, C32, C33, C34, C36, C39, C97, C108: 10uF/6.3V/20%/X5R/C0603; C_0603_5MIL_DWS
C35, C42, C43: 1uF/10V/10%/X5R/C0603; C_0603_5MIL_DWS
C37, C38, C57, C58, C59, C61, C62, C63, C64, C65, C66, C67, C68, C69, C74, C75, C76, C77, C78, C79, C80, C81, C82, C83, C84, C85, C86, C89, C90, C91, C92, C93, C94, C95, C98, C99, C100, C101, C102, C103, C104, C105, C106, C107, C109, C110, C111, C112, C113, C114, C115, C116, C117, C118: 1uF/6.3V/20%/X5R/C0201; C_0201_5MIL_DWS
C40: 100nF/10V/10%/X7R/C0402; C_0402_5MIL_DWS
C41, C56, C119: 4.7uF/6.3V/20%/X5R/C0603; C_0603_5MIL_DWS
C44, C45, C46, C47, C48, C49, C50, C51, C52, C53, C54, C55, C60, C70, C72, C87: 22uF/6.3V/20%/X5R/C0603; C_0603_5MIL_DWS
GND1: TESTPAD; TP_SMD
L1, L2, L3, L4, L5, L6: WPN252012ER47MT(0.47uH/20%/4.1A/DCR=0.026R/2.5x2.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; WPN252012ER47MT(2.5x2.0x1.2mm)
NVCC_DRAM_1V1: TESTPAD; TP_SMD
NVCC_SD2: TESTPAD; TP_SMD
NVCC_SNVS_1V8: TESTPAD; TP_SMD
Q1: Q32.768kHz/12.5pF/2P/SMD1206; CM7V-T1A(Crystal_Package-1206_3.20x1.50x0.65mm)
R11, R12: 100k/R0402; R_0402_5MIL_DWS
R13, R14, R40, R41: 4.7k/R0402; R_0402_5MIL_DWS
R15: NA(1M/R0402); R_0402_5MIL_DWS
R16, R17: NA(0R/R0402); R_0402_5MIL_DWS
R18, R19: 0R/R0402; R_0402_5MIL_DWS
U1: MIMX8ML8CVNKZAB(FCBGA548); FCBGA548_Pitch-0.5mm_Ball-0.25mm_Dimensions-15x15x1.5mm
U2: PCA9450CHN(HVQFN56); SOT949-6(HVQFN56)
U4: AT24C16C-SSHM-T(SOIC-8_150mil); SOIC-8_150mil
VDDA_1V8: TESTPAD; TP_SMD
VDD_1V8_1, VDD_3V3_1: TESTPAD; TP_SMD
VDD_ARM1: TESTPAD; TP_SMD
VDD_SOC1: TESTPAD; TP_SMD
VSD_3V3: TESTPAD; TP_SMD

Notes on the sheet:
Power Supply - PMIC
I2C Address: 0x50-0x57
EEPROM
0.8/0.9/1.0V 3A
0.8/0.9V 3A
3.3V 3A
1.8V 2A
1.1V 2A
3.3V 400mA
1.8V 10mA
0.8V 10mA
1.8V 300mA
0.8V 200mA
3.3V/1.8V 150mA
PCA9450 I2C Slave Address: 0x25
Power Supply - MCU
