OLIMEX/iMX8MP-SOM/HARDWARE/iMX8MP-SOM-xGB-IND/iMX8MPLUS-SOM_Rev_B.sch

## KiCad design HARDWARE/iMX8MP-SOM-xGB-IND/iMX8MPLUS-SOM_Rev_B.sch (2024-09-25)

Schematic: iMX8MPLUS-SOM_Rev_B.sch

Parts:
C1, C3, C9, C15, C21: 22uF/6.3V/20%/X5R/C0603; C_0603_5MIL_DWS
C2, C4, C5, C6, C7, C8, C10, C11, C12, C13, C14, C16, C17, C18, C19, C20, C22, C23, C24, C25: 1uF/6.3V/20%/X5R/C0201; C_0201_5MIL_DWS
FID1, FID2, FID3, FID4, FID5, FID6: Fiducial; Fiducial1x3
IC1: K4F6E304HB-MGCJ; BGA200_LPDDR4_0.3mm_ball
MH1, MH2, MH3, MH4: Mounting_Hole_NPTH; Mounting_Hole_Drill-3.3mm_Clerance-7mm
R1: 10k/R0402; R_0402_5MIL_DWS
R2, R9, R10: 240R/1%/R0402; R_0402_5MIL_DWS
R3, R4, R6, R7: NA(10k/R0402); R_0402_5MIL_DWS
R5, R8: NA(150R/1%/R0402); R_0402_5MIL_DWS
U1: MIMX8ML8CVNKZAB(FCBGA548); FCBGA548_Pitch-0.5mm_Ball-0.25mm_Dimensions-15x15x1.5mm

Notes on the sheet:
LPDDR4 6GB
Note: 1. LPDDR4 ODT on i.MX 8M Plus is command-based, ODT_CA_A/B of LPDDR4 part should be connected directly to VDD2. 2. We have used a number of fully compatible, but different LPDDR4 memories due to supply unavailability. In such cases the memory part name in the schematic might remain outdated. 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
